jakelongo/l2_dev_board/BOM.xls

Item No. | Quantity | Description | Footprint | Reference | Manufacturer | Part Number | Unit Price (£) | Line Price (£) | Comments | Link
1 | 1 | MLCC 10nF 0603 X7R 50V | 0603 | C108 | Murata | GRM188R71H103KA01 | 0.0250 | 0.0200 |  | http://search.digikey.com/scripts/DkSearch/dksus.dll?Detail&name=490-1512-1-ND
2 | 1 | MLCC 0.22uF 0603 X7R 10V | 0603 | C103 | Murata | GRM188R71A224KA01D | 0.0930 | 0.0742 |  | http://search.digikey.com/scripts/DkSearch/dksus.dll?Detail&name=490-1535-2-ND
3 | 64 | MLCC 100nF 0402 X7R 16V | 0402 | C302,C303,C304,C305,C307,C308,C309,C310,C402,C403,C404,C405,C407,C408,C409,C410,C602,C603,C604,C605,C607,C608,C609,C610,C702,C703,C704,C705,C707,C708,C709,C710,C902,C903,C904,C905,C907,C908,C909,C910,C1002,C1003,C1004,C1005,C1007,C1008,C1009,C1010,C1202,C1203,C1204,C1205,C1207,C1208,C1209,C1210,C1302,C1303,C1304,C1305,C1307,C1308,C1309,C1310 | Murata | GRM155R71C104KA88 | 0.0182 | 0.0072 |  | http://search.digikey.com/scripts/DkSearch/dksus.dll?Detail&name=490-3261-1-ND
4 | 28 | MLCC 10uF 0805 X5R 10V | 0805 | C104,C105,C107,C109,C201,C203,C306,C311,C406,C411,C501,C503,C606,C611,C706,C711,C801,C803,C906,C911,C1006,C1011,C1101,C1103,C1206,C1211,C1306,C1311 | Murata | GRM21BR61A106KE19 | 0.2840 | 0.0945 |  | http://search.digikey.com/scripts/DkSearch/dksus.dll?Detail&name=490-1709-1-ND
5 | 8 | MLCC 100nF 0603 X7R 16V | 0603 | C301,C401,C601,C701,C901,C1001,C1201,C1301 | Murata | GRM188R71C104KA01 | 0.0260 | 0.0208 |  | http://search.digikey.com/scripts/DkSearch/dksus.dll?Detail&name=490-1532-1-ND
6 | 5 | MLCC 33pF 0603 COG 50V | 0603 | C106,C202,C502,C802,C1102 | Murata | GRM1885C1H330JA01 | 0.0390 | 0.0310 |  | http://search.digikey.com/scripts/DkSearch/dksus.dll?Detail&name=490-1415-1-ND
7 | 1 | MLCC 4.7uF 0805 X5R 25V | 0805 | C101 | Murata | GRM21BR61E475KA12L | 0.3900 | 0.3090 |  | http://search.digikey.com/scripts/DkSearch/dksus.dll?Detail&name=490-3335-1-ND
8 | 1 | MLCC 470pF 0603 X7R 50V | 0603 | C102 | Murata | GRM188R71H471KA01D | 0.0580 | 0.0466 |  | http://search.digikey.com/scripts/DkSearch/dksus.dll?Detail&name=490-1489-1-ND
9 | 8 | RES 2.2R 0603 1% 0.1W | 0603 | R301,R401,R601,R701,R901,R1001,R1201,R1301 | ROHM | MCR03EZPJ2R2 | 0.0180 | 0.0138 |  | http://search.digikey.com/scripts/DkSearch/dksus.dll?Detail&name=RHM2.2GCT-ND
10 | 27 | RES 33R 0603 1% 0.1W | 0603 | R115,R116,R117,R121,R122,R123,R124,R125,R126,R127,R128,R129,R131,R136,R141,R146,R151,R160,R165,R166,R171,R176,R181,R201,R501,R801,R1101 | ROHM | MCR03EZPFX33R0 | 0.0230 | 0.0098 |  | http://search.digikey.com/scripts/DkSearch/dksus.dll?Detail&name=RHM33.0HCT-ND
11 | 32 | RES 1k 0603 1% 0.1W | 0603 | R302,R303,R304,R305,R402,R403,R404,R405,R602,R603,R604,R605,R702,R703,R704,R705,R902,R903,R904,R905,R1002,R1003,R1004,R1005,R1202,R1203,R1204,R1205,R1302,R1303,R1304,R1305 | ROHM | MCR03EZPFX1001 | 0.0230 | 0.0098 |  | http://search.digikey.com/scripts/DkSearch/dksus.dll?Detail&name=RHM1.00KHCT-ND
12 | 8 | RES 10k 0603 1% 0.1W | 0603 | R103,R104,R105,R106,R107,R112,R113,R114 | ROHM | MCR03EZPFX1002 | 0.0230 | 0.0098 |  | http://search.digikey.com/scripts/DkSearch/dksus.dll?Detail&name=RHM10.0KHCT-ND
13 | 1 | RES 11.5k 0603 1% 0.1W | 0603 | R102 | ROHM | MCR03EZPFX1152 | 0.0230 | 0.0230 |  | http://search.digikey.com/scripts/DkSearch/dksus.dll?Detail&name=RHM11.5KHCT-ND
14 | 1 | RES 16.5k 0603 1% 0.1W | 0603 | R101 | ROHM | MCR03EZPFX1622 | 0.0230 | 0.0230 |  | http://search.digikey.com/scripts/DkSearch/dksus.dll?Detail&name=RHM16.2KHCT-ND
15 | 1 | RES 453k 0603 1% 0.1W | 0603 | R110 | ROHM | MCR03EZPFX4533 | 0.0230 | 0.0230 |  | http://search.digikey.com/scripts/DkSearch/dksus.dll?Detail&name=RHM453KHCT-ND
16 | 1 | RES 536k 0603 1% 0.1W | 0603 | R109 | ROHM | MCR03EZPFX5363 | 0.0230 | 0.0230 |  | http://search.digikey.com/scripts/DkSearch/dksus.dll?Detail&name=RHM536KHCT-ND
17 | 6 | RES 100k 0603 1% 0.1W | 0603 | R108,R111,R204,R504,R804,R1104 | ROHM | MCR03EZPJ104 | 0.0180 | 0.0138 |  | http://search.digikey.com/scripts/DkSearch/dksus.dll?Detail&name=RHM100KGCT-ND
18 | 4 | RES 68k 0603 1% 0.1W | 0603 | R203,R503,R803,R1103 | ROHM | MCR03EZPJ683 | 0.0180 | 0.0180 |  | http://search.digikey.com/scripts/DkSearch/dksus.dll?Detail&name=RHM68KGCT-ND
19 | 5 | 2u2H | NCLV | L102,L201,L501,L801,L1101 | TDK Corporation | NLCV32T-2R2M-PFR | 0.2300 | 0.2062 |  | http://search.digikey.com/scripts/DkSearch/dksus.dll?Detail&name=445-3650-1-ND
20 | 1 | 2u2H | LQH55P | L101 | Murata | LQH55PN2R2NR0L | 0.8200 | 0.6900 |  | http://search.digikey.com/scripts/DkSearch/dksus.dll?Detail&name=490-5266-1-ND
21 | 1 | 74AHC1GU04 | SOT25-5 | U111 | Diodes Inc | 74AHC1GU04W5-7 | 0.5600 | 0.3830 |  | http://search.digikey.com/scripts/DkSearch/dksus.dll?Detail&name=74AHC1GU04W5-7DICT-ND
22 | 1 | A6RS-161RF | AR6S-SWT | U103 | Omron Electronics | A6RS-161RF-P | 3.8100 | 3.8100 |  | http://search.digikey.com/scripts/DkSearch/dksus.dll?Detail&name=SW1026CT-ND
23 | 2 | APX803-SR | SOT23-3 | U101,U110 | Diodes Inc | APX803-29SRG-7 | 0.5200 | 0.4100 |  | http://search.digikey.com/scripts/DkSearch/dksus.dll?Detail&name=APX803-29SRG-7DICT-ND
24 | 1 | ASE_CLK 20Mhz | SMD-4 | U123 | Abracon Corporation | ASE-20.000MHZ-ET | 2.4000 | 2.0800 |  | http://search.digikey.com/scripts/DkSearch/dksus.dll?Detail&name=535-9983-1-ND
25 | 10 | CONN_30 | comments | P101,P102,P103,P104,P105,P106,P107,P108,P109,P110 | Toby | FFC5-30-R-L-TU | 0.6200 | 0.5200 | Check datasheet for footprint | http://www.toby.co.uk/content/catalogue/products.aspx?series=FFC5-xx-R-L-Tx
26 | 1 | CONN_7 7 PIN JTAG HEADER | N/A | P112 | N/A | N/A |  |  | DNP
27 | 1 | DIODE_SCH | DFLS240L | D101 | Diodes Inc | DFLS240L-7 | 0.7900 | 0.6840 |  | http://search.digikey.com/scripts/DkSearch/dksus.dll?Detail&name=DFLS240LDICT-ND
28 | 32 | LED GRN | 603 | D301,D302,D303,D304,D401,D402,D403,D404,D601,D602,D603,D604,D701,D702,D703,D704,D901,D902,D903,D904,D1001,D1002,D1003,D1004,D1201,D1202,D1203,D1204,D1301,D1302,D1303,D1304 | Knightsbright Corp | APT1608CGCK | 0.1020 | 0.0850 |  | http://search.digikey.com/scripts/DkSearch/dksus.dll?Detail&name=754-1116-1-ND
29 | 1 | LT3480 DC-DC BUCK 2A | 10DFN | U109 | Linear Technology | LT3480EDD#PBF | 6.9000 | 6.9000 |  | http://search.digikey.com/scripts/DkSearch/dksus.dll?Detail&name=LT3480EDD%23PBF-ND
30 | 2 | NC7WZ07 OPN DRN BUF | SC70-6 | U119,U127 | Fairchild Semiconductor | NC7WZ07P6X | 0.4700 | 0.4700 |  | http://search.digikey.com/scripts/DkSearch/dksus.dll?Detail&name=NC7WZ07P6XCT-ND
31 | 18 | NC7WZ17 BUF | SC70-6 | U112,U113,U114,U115,U118,U120,U125,U126,U128,U131,U201,U202,U501,U502,U801,U802,U1101,U1102 | Fairchild Semiconductor | NC7WZ17P6X | 0.4700 | 0.2016 |  | http://search.digikey.com/scripts/DkSearch/dksus.dll?Detail&name=NC7WZ17P6XCT-ND
32 | 5 | NCP1529 DC-DC BUCK 1A | SOT23-5 | U117,U203,U503,U803,U1103 | ON Semiconductor | NCP1529ASNT1G | 0.9500 | 0.8500 |  | http://search.digikey.com/scripts/DkSearch/dksus.dll?Detail&name=NCP1529ASNT1GOSCT-ND
33 | 1 | CON PWR JCK 2.5 X 6.5MM VERT | PJ-044BH | P111 | CUI Inc | PJ-044BH | 1.2200 | 0.8540 |  | http://search.digikey.com/scripts/DkSearch/dksus.dll?Detail&name=CP-044BH-ND
34 | 2 | SN74CBTD3861 10-BIT FET BUS SWTCH | TSSOP-24 | U108,U116 | Texas Instruments | SN74CBTD3861PWR | 0.7000 | 0.5440 |  | http://search.digikey.com/scripts/DkSearch/dksus.dll?Detail&name=296-6487-1-ND
35 | 4 | SN74LVC1G18 NON-INV DEMUX | SOT23-6 | U104,U105,U106,U107 | Texas Instruments | SN74LVC1G18DBVR | 0.4400 | 0.2852 |  | http://search.digikey.com/scripts/DkSearch/dksus.dll?Detail&name=296-15568-1-ND
36 | 8 | XS1_L2-QFN124 | QFN124 | U301,U401,U601,U701,U901,U1001,U1201,U1301 | XMOS | XS1-L02A-QF124-C5 | 9.1500 | 6.1000 |  | http://www.xmos.com/published/xs1-l02a-qf124-datasheet
37 | 12 | YC124 | 4x0402 | U102,U121,U122,U124,U129,U130,U132,U133,U134,U135,U136,U137 | YAGEO | YC124-JR-0733RL | 0.1060 | 0.0960 |  | http://uk.farnell.com/yageo-phycomp/yc124-jr-0733rl/resistor-array-arv341-0804-33r/dp/9235272
