jakelongo/l2_dev_board/XMP16/BOM/BOM.xlsx

Item No. | Reference | Quantity | Desctiption | Package | Unit Cost (£) | Line Cost (10) (£) | Datasheet
1 | C108 | 1 | CAP 0.1uF | 0603 | 0.013 | 0.003
2 | C103 | 1 | CAP 0.22uF | 0603 | 0.013 | 0.003
3 | R108, R111, R204, R504, R804, R1104 | 6 | RES 100k | 0603 | 0.110 | 0.002
4 | C302, C303, C304, C305, C307, C308, C309, C310, C402, C403, C404, C405, C407, C408, C409, C410, C602, C603, C604, C605, C607, C608, C609, C610, C702, C703, C704, C705, C707, C708, C709, C710, C902, C903, C904, C905, C907, C908, C909, C910, C1002, C1003, C1004, C1005, C1007, C1008, C1009, C1010, C1202, C1203, C1204, C1205, C1207, C1208, C1209, C1210, C1302, C1303, C1304, C1305, C1307, C1308, C1309, C1310 | 64 | RES 100nF | 0402 | 0.013 | 0.003
5 | R103, R104, R105, R106, R107, R112, R113, R114 | 8 | RES 10k | 0603 | 0.110 | 0.002
6 | C105, C107, C201, C203, C306, C311, C406, C411, C501, C503, C606, C611, C706, C711, C801, C803, C906, C911, C1006, C1011, C1101, C1103, C1206, C1211, C1306, C1311 | 26 | CAP 10uF | 0603 | 0.013 | 0.003
7 | R102 | 1 | RES 11.5k | 0603 | 0.110 | 0.002
8 | C104 | 1 | CAP 15uF | 0603 | 0.013 | 0.003
9 | R101 | 1 | RES 16.2k | 0603 | 0.110 | 0.002
10 | R302, R303, R304, R305, R402, R403, R404, R405, R602, R603, R604, R605, R702, R703, R704, R705, R902, R903, R904, R905, R1002, R1003, R1004, R1005, R1202, R1203, R1204, R1205, R1302, R1303, R1304, R1305 | 32 | RES 1k | 0603 | 0.110 | 0.002
11 | C301, C401, C601, C701, C901, C1001, C1201, C1301 | 8 | CAP 1uF | 0603 | 0.013 | 0.003
12 | R301, R401, R601, R701, R901, R1001, R1201, R1301 | 8 | RES 2R2 | 0603 | 0.110 | 0.002
13 | L102, L201, L501, L801, L1101 | 5 | IND 2u2H | NCLV | 0.160 | 0.140 | http://search.digikey.com/scripts/DkSearch/dksus.dll?Detail&name=445-3650-1-ND
14 | L101 | 1 | IND 2u2H | LQH55P | 0.560 | 0.469 | http://search.murata.co.jp/Ceramy/image/img/PDF/ENG/L0075S0103LQH55P.pdf
15 | C106, C202, C502, C802, C1102 | 5 | CAP 33pF | 0603 | 0.013 | 0.003
16 | R115, R116, R117, R121, R122, R123, R124, R125, R126, R127, R128, R129, R131, R136, R141, R146, R151, R160, R165, R166, R171, R176, R181, R201, R501, R801, R1101 | 27 | RES 33R | 0603 | 0.110 | 0.002
17 | C101 | 1 | CAP 4.7uF | 0603 | 0.013 | 0.003
18 | R110 | 1 | RES 453k | 0603 | 0.110 | 0.002
19 | C102 | 1 | CAP 470pF | 0603 | 0.013 | 0.003
20 | R109 | 1 | RES 536k | 0603 | 0.110 | 0.002
21 | R203, R503, R803, R1103 | 4 | RES 68k | 0603 | 0.110 | 0.002
22 | U111 | 1 | 74AHC1GU04 | SOT25-5 | 0.380 | 0.260 | http://search.digikey.com/scripts/DkSearch/dksus.dll?Detail&name=74AHC1GU04W5-7DICT-ND
23 | U103 | 1 | A6RS-161RF | AR6S-SWT | 2.590 | 2.590 | http://search.digikey.com/scripts/DkSearch/dksus.dll?Detail&name=SW1026CT-ND
24 | U101, U110 | 2 | APX803-SR | SOT23-3 | 0.450 | 0.346 | http://search.digikey.com/scripts/DkSearch/dksus.dll?Detail&name=535-9983-1-ND
25 | U123 | 1 | ASE_CLK | SMD-4 | 1.630 | 1.413 | http://search.digikey.com/scripts/DkSearch/dksus.dll?Detail&name=535-9983-1-ND
26 | P101, P102, P103, P104, P105, P106, P107, P108, P109, P110 | 10 | CONN_30 |  | 0.620 | 0.520 | http://www.toby.co.uk/content/catalogue/products.aspx?series=FFC5-xx-R-L-Tx
27 | D101 | 1 | DIODE_SCH | DFLS240L | 0.540 | 0.465 | http://search.digikey.com/scripts/DkSearch/dksus.dll?Detail&name=DFLS240LDICT-ND
28 | D301, D302, D303, D304, D401, D402, D403, D404, D601, D602, D603, D604, D701, D702, D703, D704, D901, D902, D903, D904, D1001, D1002, D1003, D1004, D1201, D1202, D1203, D1204, D1301, D1302, D1303, D1304 | 32 | LED | 603 | 0.520 | 0.099 | http://search.digikey.com/scripts/DkSearch/dksus.dll?Detail&name=296-23770-1-ND
29 | U109 | 1 | LT3480 | 10DFN | 4.970 | 4.970 | http://search.digikey.com/scripts/DkSearch/dksus.dll?Detail&name=LT3480EDD%23PBF-ND
30 | U119, U127 | 2 | NC7WZ07 | SC70-6 | 0.320 | 0.137 | http://search.digikey.com/scripts/DkSearch/dksus.dll?Detail&name=NC7WZ17P6XCT-ND
31 | U112, U113, U114, U115, U118, U120, U125, U126, U128, U131, U201, U202, U501, U502, U801, U802, U1101, U1102 | 18 | NC7WZ17 | SC70-6 | 0.320 | 0.137 | http://search.digikey.com/scripts/DkSearch/dksus.dll?Detail&name=NC7WZ17P6XCT-ND
32 | U117, U203, U503, U803, U1103 | 5 | NCP1529 | SOT23-5 | 0.650 | 0.577 | http://search.digikey.com/scripts/DkSearch/dksus.dll?Detail&name=NCP1529ASNT1GOSCT-ND
33 | U108, U116 | 2 | SN74CBTD3861 | TSSOP-24 | 0.480 | 0.480 | http://search.digikey.com/scripts/DkSearch/dksus.dll?Detail&name=296-6487-1-ND
34 | U104, U105, U106, U107 | 4 | SN74LVC1G18 | SOT23-6 | 0.300 | 0.194 | http://search.digikey.com/scripts/DkSearch/dksus.dll?Detail&name=296-15568-1-ND
35 | U301, U401, U601, U701, U901, U1001, U1201, U1301 | 8 | XS1_L2-QFN124 |  | 9.158 | 6.105 | http://www.xmos.com/published/xs1-l02a-qf124-datasheet
36 | U102, U121, U122, U124, U129, U130, U132, U133, U134, U135, U136, U137 | 12 | YC124 | 4x0402 | 0.106 | 0.103 | http://uk.farnell.com/yageo-phycomp/yc124-jr-0733rl/resistor-array-arv341-0804-33r/dp/9235272
37 | P111 | 1 | POWER JACK PJ-044BH | PJ-044BH | 0.830 | 0.580 | http://search.digikey.com/scripts/DkSearch/dksus.dll?Detail&name=CP-044BH-ND
