jakelongo/l2_dev_board/l2_dev_alternative _nopwrsense/l1.sch

## KiCad design l2_dev_alternative _nopwrsense/l1.sch (2011-08-31)

Schematic: l1.sch

Parts:
C1401, C1402, C1405, C1406, C1412, C1417: 10uF
C1403, C1404: 33pF
C1407, C1408, C1409, C1410, C1413, C1414, C1415, C1416: 100nF
C1411: 1uF
L1401, L1402: 2u2H
R1403: 453k
R1404, R1406: 100k
R1405: 68k
R1407, R1409: 10k
R1408: 4R7
U1401, U1402: NC7WZ17
U1403: NCP1529
U1404: NCP1521B
U1405, U1406: APX803-SR
U1407: XS1-L1-128

Notes on the sheet:
L1 128 TQFP
RESET SUPERVISOR
Decoupling Caps
5V to 1V0 @ 0.6A
5V to 3V3 @ 1A
JTAG Buffering
