jakelongo/l2_dev_board/l2_dev_alternative _nopwrsense/l2.sch

## KiCad design l2_dev_alternative _nopwrsense/l2.sch (2011-09-13)

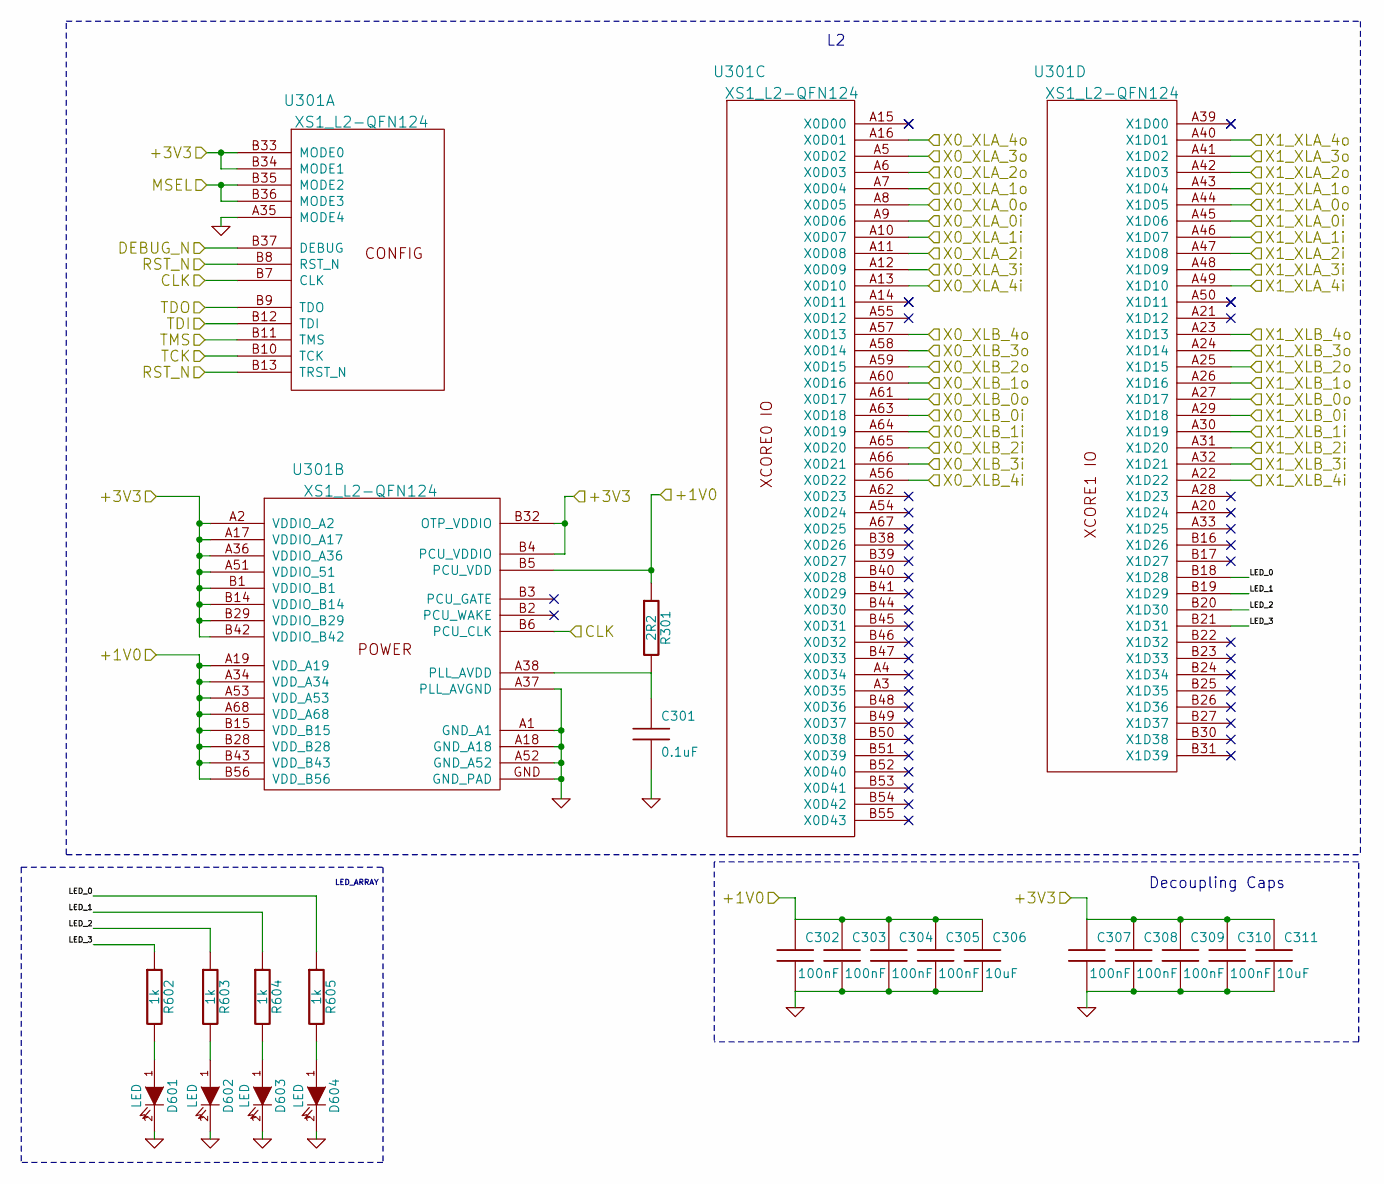
[picture p1: schematic l2.sch]

Parts:
C301: 0.1uF; 0603
C302, C303, C304, C305, C307, C308, C309, C310: 100nF; 0402
C306, C311: 10uF; 0603
D302, D303, D304, D401: LED; 0603
R301: 2R2; 0603
R303, R304, R305, R402: 1k; 0603
U301: XS1_L2-QFN124; QFN124

Connections:
+1V0: C302.1, C303.1, C304.1, C305.1, C306.1, R301.1, U301.A19 (VDD_A19), U301.A34 (VDD_A34), U301.A53 (VDD_A53), U301.A68 (VDD_A68), U301.B5 (PCU_VDD), U301.B15 (VDD_B15), U301.B28 (VDD_B28), U301.B43 (VDD_B43), U301.B56 (VDD_B56)
+3V3: C307.1, C308.1, C309.1, C310.1, C311.1, U301.A2 (VDDIO_A2), U301.A17 (VDDIO_A17), U301.A36 (VDDIO_A36), U301.A51 (VDDIO_51), U301.B1 (VDDIO_B1), U301.B4 (PCU_VDDIO), U301.B14 (VDDIO_B14), U301.B29 (VDDIO_B29), U301.B32 (OTP_VDDIO), U301.B33 (MODE0), U301.B34 (MODE1), U301.B42 (VDDIO_B42)
CLK: U301.B6 (PCU_CLK), U301.B7 (CLK)
DEBUG_N: U301.B37 (DEBUG)
GND: C301.2, C302.2, C303.2, C304.2, C305.2, C306.2, C307.2, C308.2, C309.2, C310.2, C311.2, D302.2 (K), D303.2 (K), D304.2 (K), D401.2 (K), U301.A1 (GND_A1), U301.A18 (GND_A18), U301.A35 (MODE4), U301.A37 (PLL_AVGND), U301.A52 (GND_A52), U301.GND (GND_PAD)
LED_0: R305.1, U301.B18 (X1D28)
LED_1: R304.1, U301.B19 (X1D29)
LED_2: R303.1, U301.B20 (X1D30)
LED_3: R402.1, U301.B21 (X1D31)
MSEL: U301.B35 (MODE2), U301.B36 (MODE3)
unnamed: C301.1, R301.2, U301.A38 (PLL_AVDD)
unnamed: D302.1 (A), R303.2
unnamed: D303.1 (A), R304.2
unnamed: D304.1 (A), R305.2
unnamed: D401.1 (A), R402.2
RST_N: U301.B8 (RST_N), U301.B13 (TRST_N)
TCK: U301.B10 (TCK)
TDI: U301.B12 (TDI)
TDO: U301.B9 (TDO)
TMS: U301.B11 (TMS)
X0_XLA_0i: U301.A9 (X0D06)
X0_XLA_0o: U301.A8 (X0D05)
X0_XLA_1i: U301.A10 (X0D07)
X0_XLA_1o: U301.A7 (X0D04)
X0_XLA_2i: U301.A11 (X0D08)
X0_XLA_2o: U301.A6 (X0D03)
X0_XLA_3i: U301.A12 (X0D09)
X0_XLA_3o: U301.A5 (X0D02)
X0_XLA_4i: U301.A13 (X0D10)
X0_XLA_4o: U301.A16 (X0D01)
X0_XLB_0i: U301.A63 (X0D18)
X0_XLB_0o: U301.A61 (X0D17)
X0_XLB_1i: U301.A64 (X0D19)
X0_XLB_1o: U301.A60 (X0D16)
X0_XLB_2i: U301.A65 (X0D20)
X0_XLB_2o: U301.A59 (X0D15)
X0_XLB_3i: U301.A66 (X0D21)
X0_XLB_3o: U301.A58 (X0D14)
X0_XLB_4i: U301.A56 (X0D22)
X0_XLB_4o: U301.A57 (X0D13)
X1_XLA_0i: U301.A45 (X1D06)
X1_XLA_0o: U301.A44 (X1D05)
X1_XLA_1i: U301.A46 (X1D07)
X1_XLA_1o: U301.A43 (X1D04)
X1_XLA_2i: U301.A47 (X1D08)
X1_XLA_2o: U301.A42 (X1D03)
X1_XLA_3i: U301.A48 (X1D09)
X1_XLA_3o: U301.A41 (X1D02)
X1_XLA_4i: U301.A49 (X1D10)
X1_XLA_4o: U301.A40 (X1D01)
X1_XLB_0i: U301.A29 (X1D18)
X1_XLB_0o: U301.A27 (X1D17)
X1_XLB_1i: U301.A30 (X1D19)
X1_XLB_1o: U301.A26 (X1D16)
X1_XLB_2i: U301.A31 (X1D20)
X1_XLB_2o: U301.A25 (X1D15)
X1_XLB_3i: U301.A32 (X1D21)
X1_XLB_3o: U301.A24 (X1D14)
X1_XLB_4i: U301.A22 (X1D22)
X1_XLB_4o: U301.A23 (X1D13)

Notes on the sheet:
LED_ARRAY
Decoupling Caps
