jakelongo/l2_dev_board/l2_dev_alternative _nopwrsense/l2_dev_board.sch

## KiCad design l2_dev_alternative _nopwrsense/l2_dev_board.sch (2011-09-13)

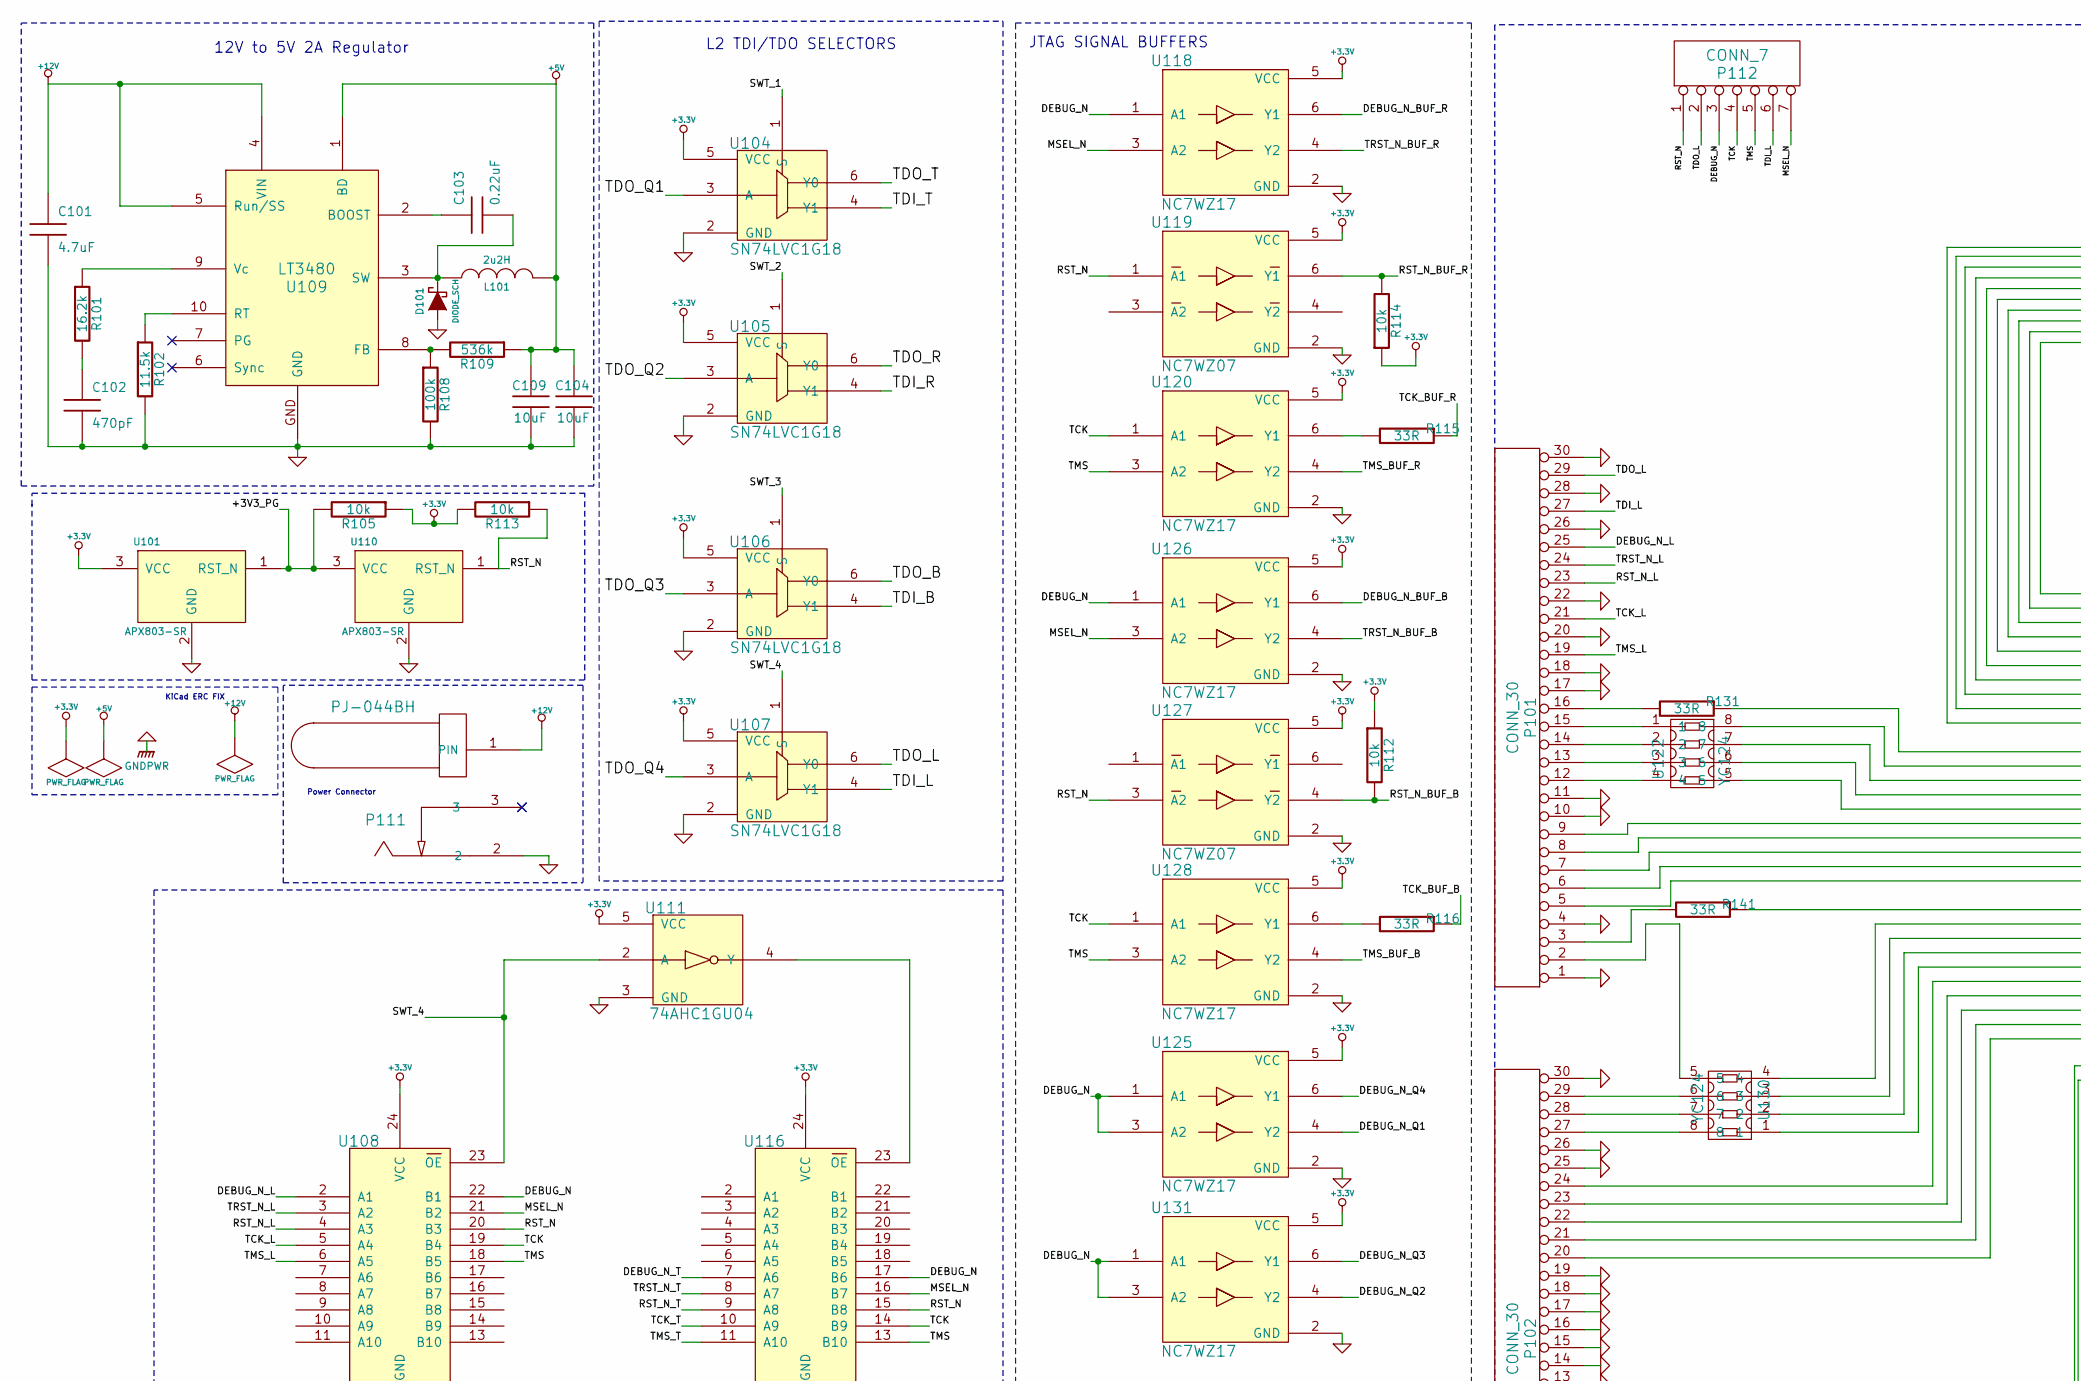
[picture p2: schematic l2_dev_board.sch, part in row 1, column 1]

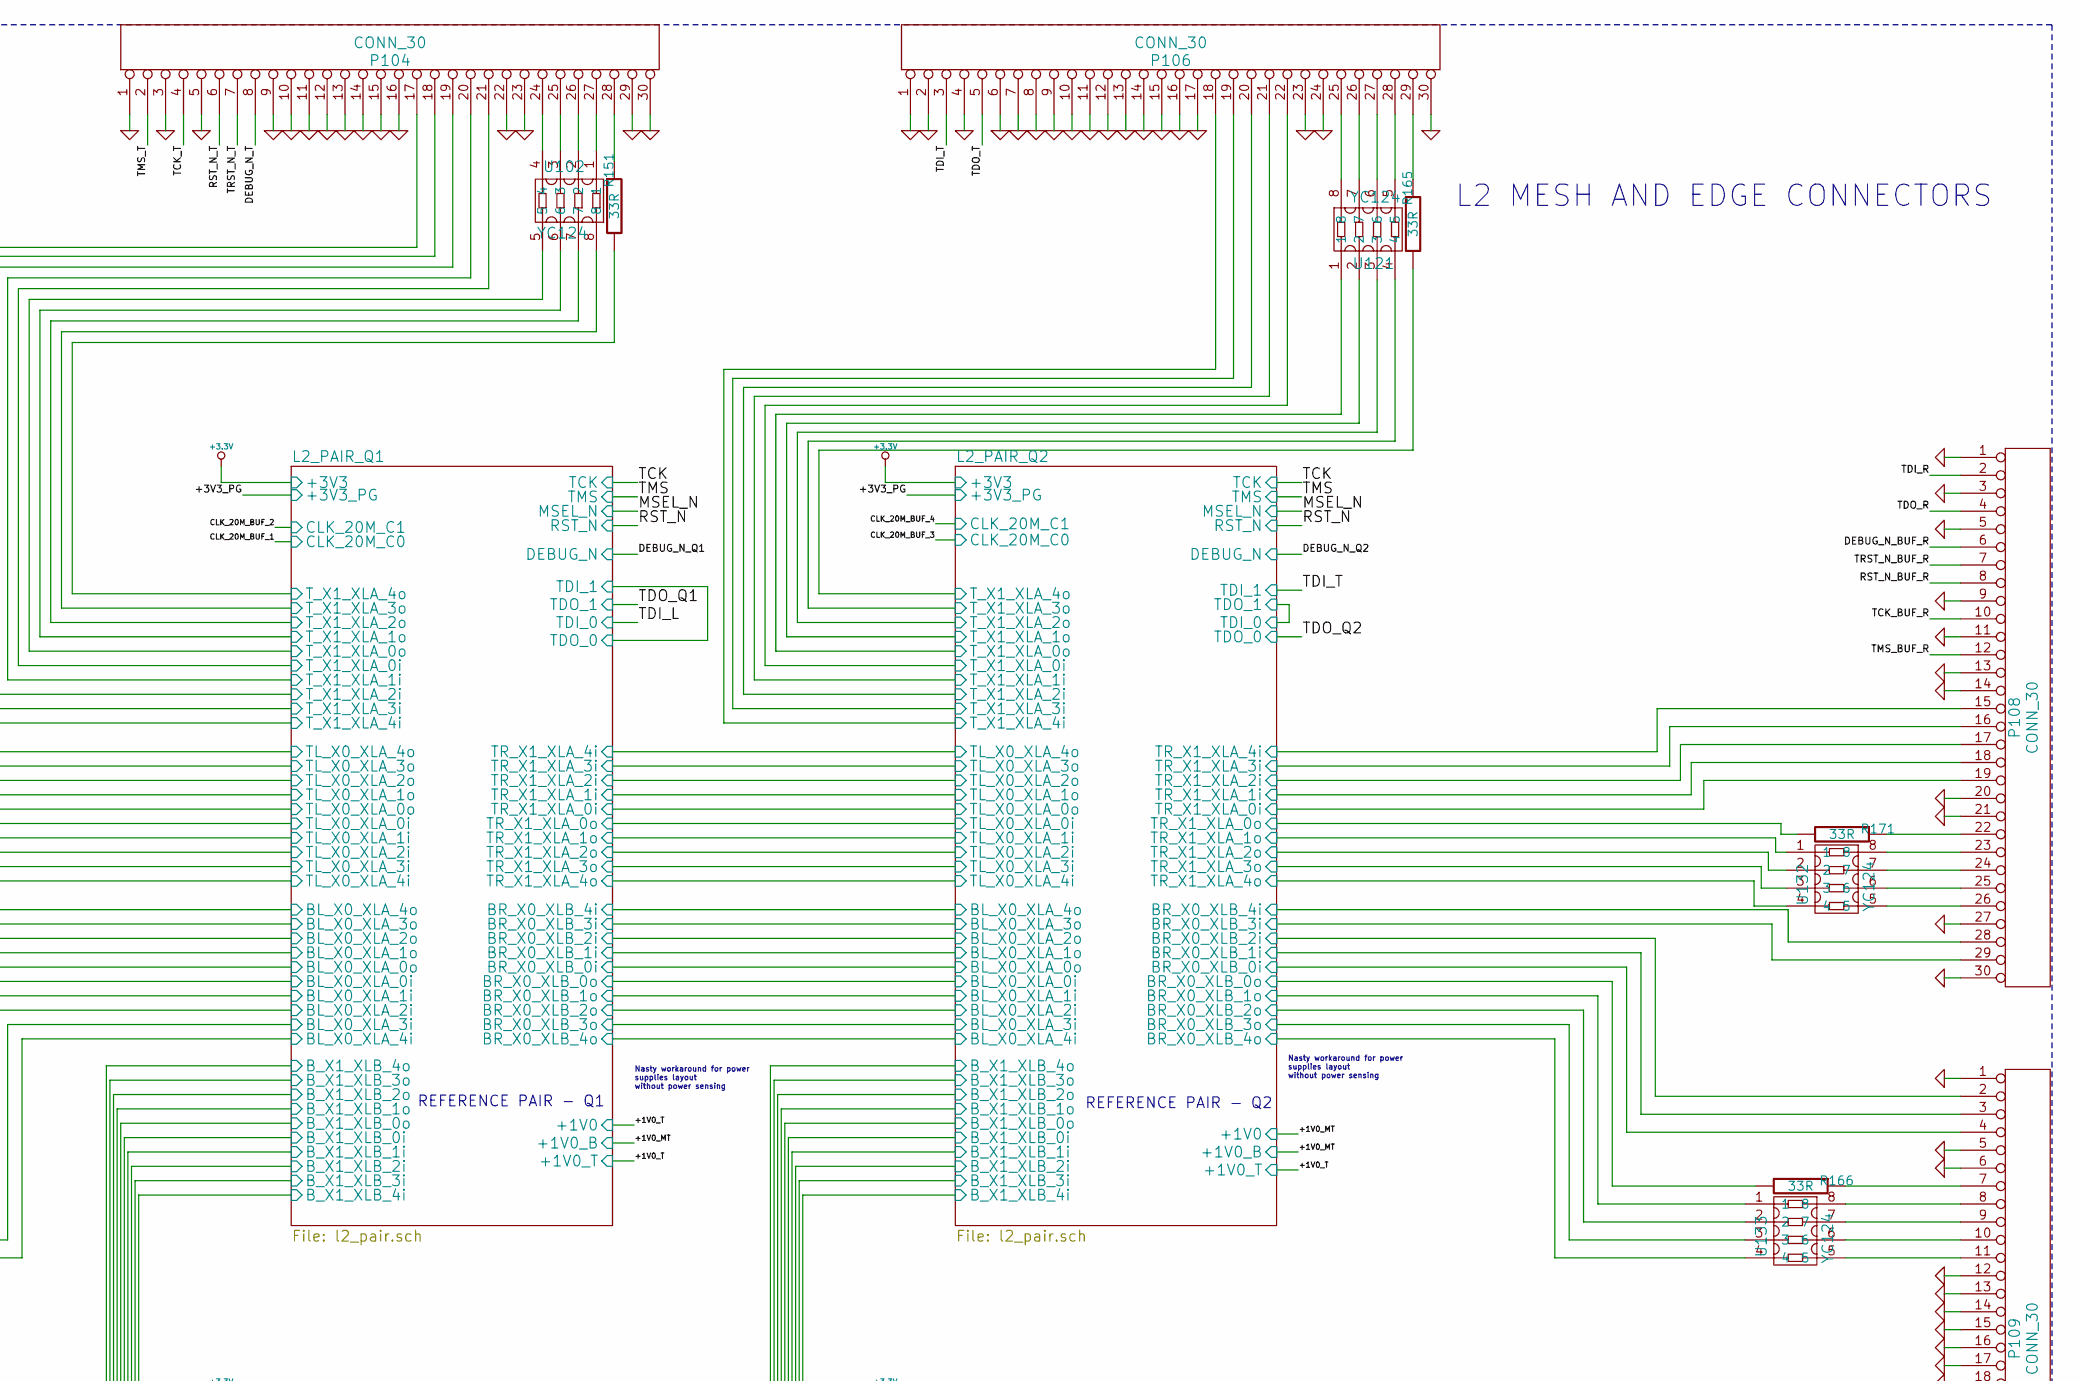
[picture p3: schematic l2_dev_board.sch, part in row 1, column 2]

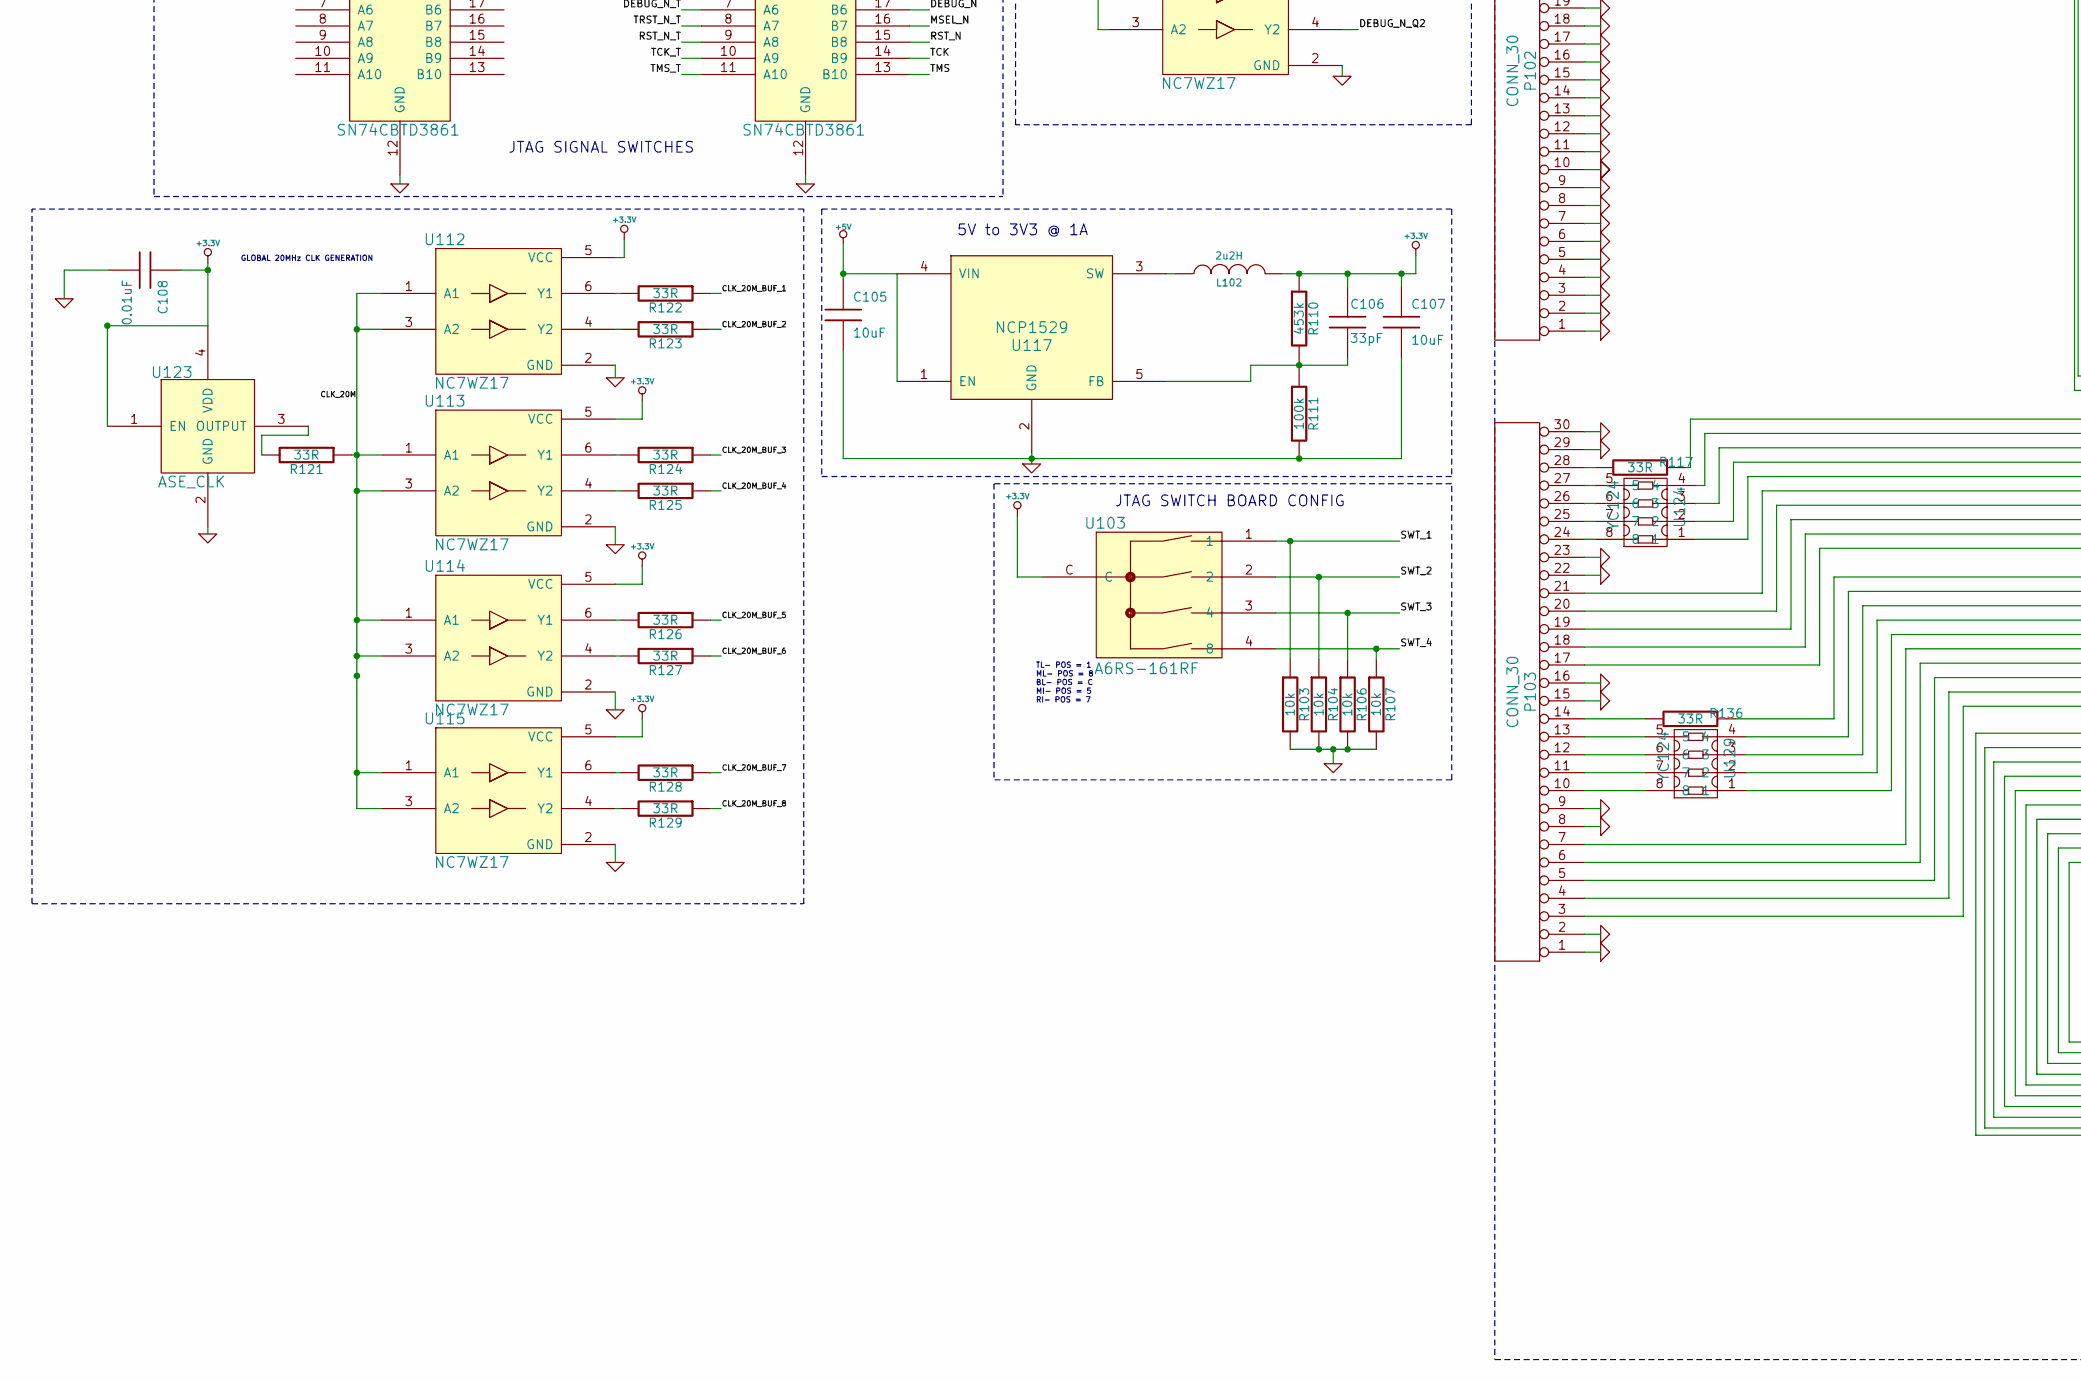
[picture p4: schematic l2_dev_board.sch, part in row 2, column 1]

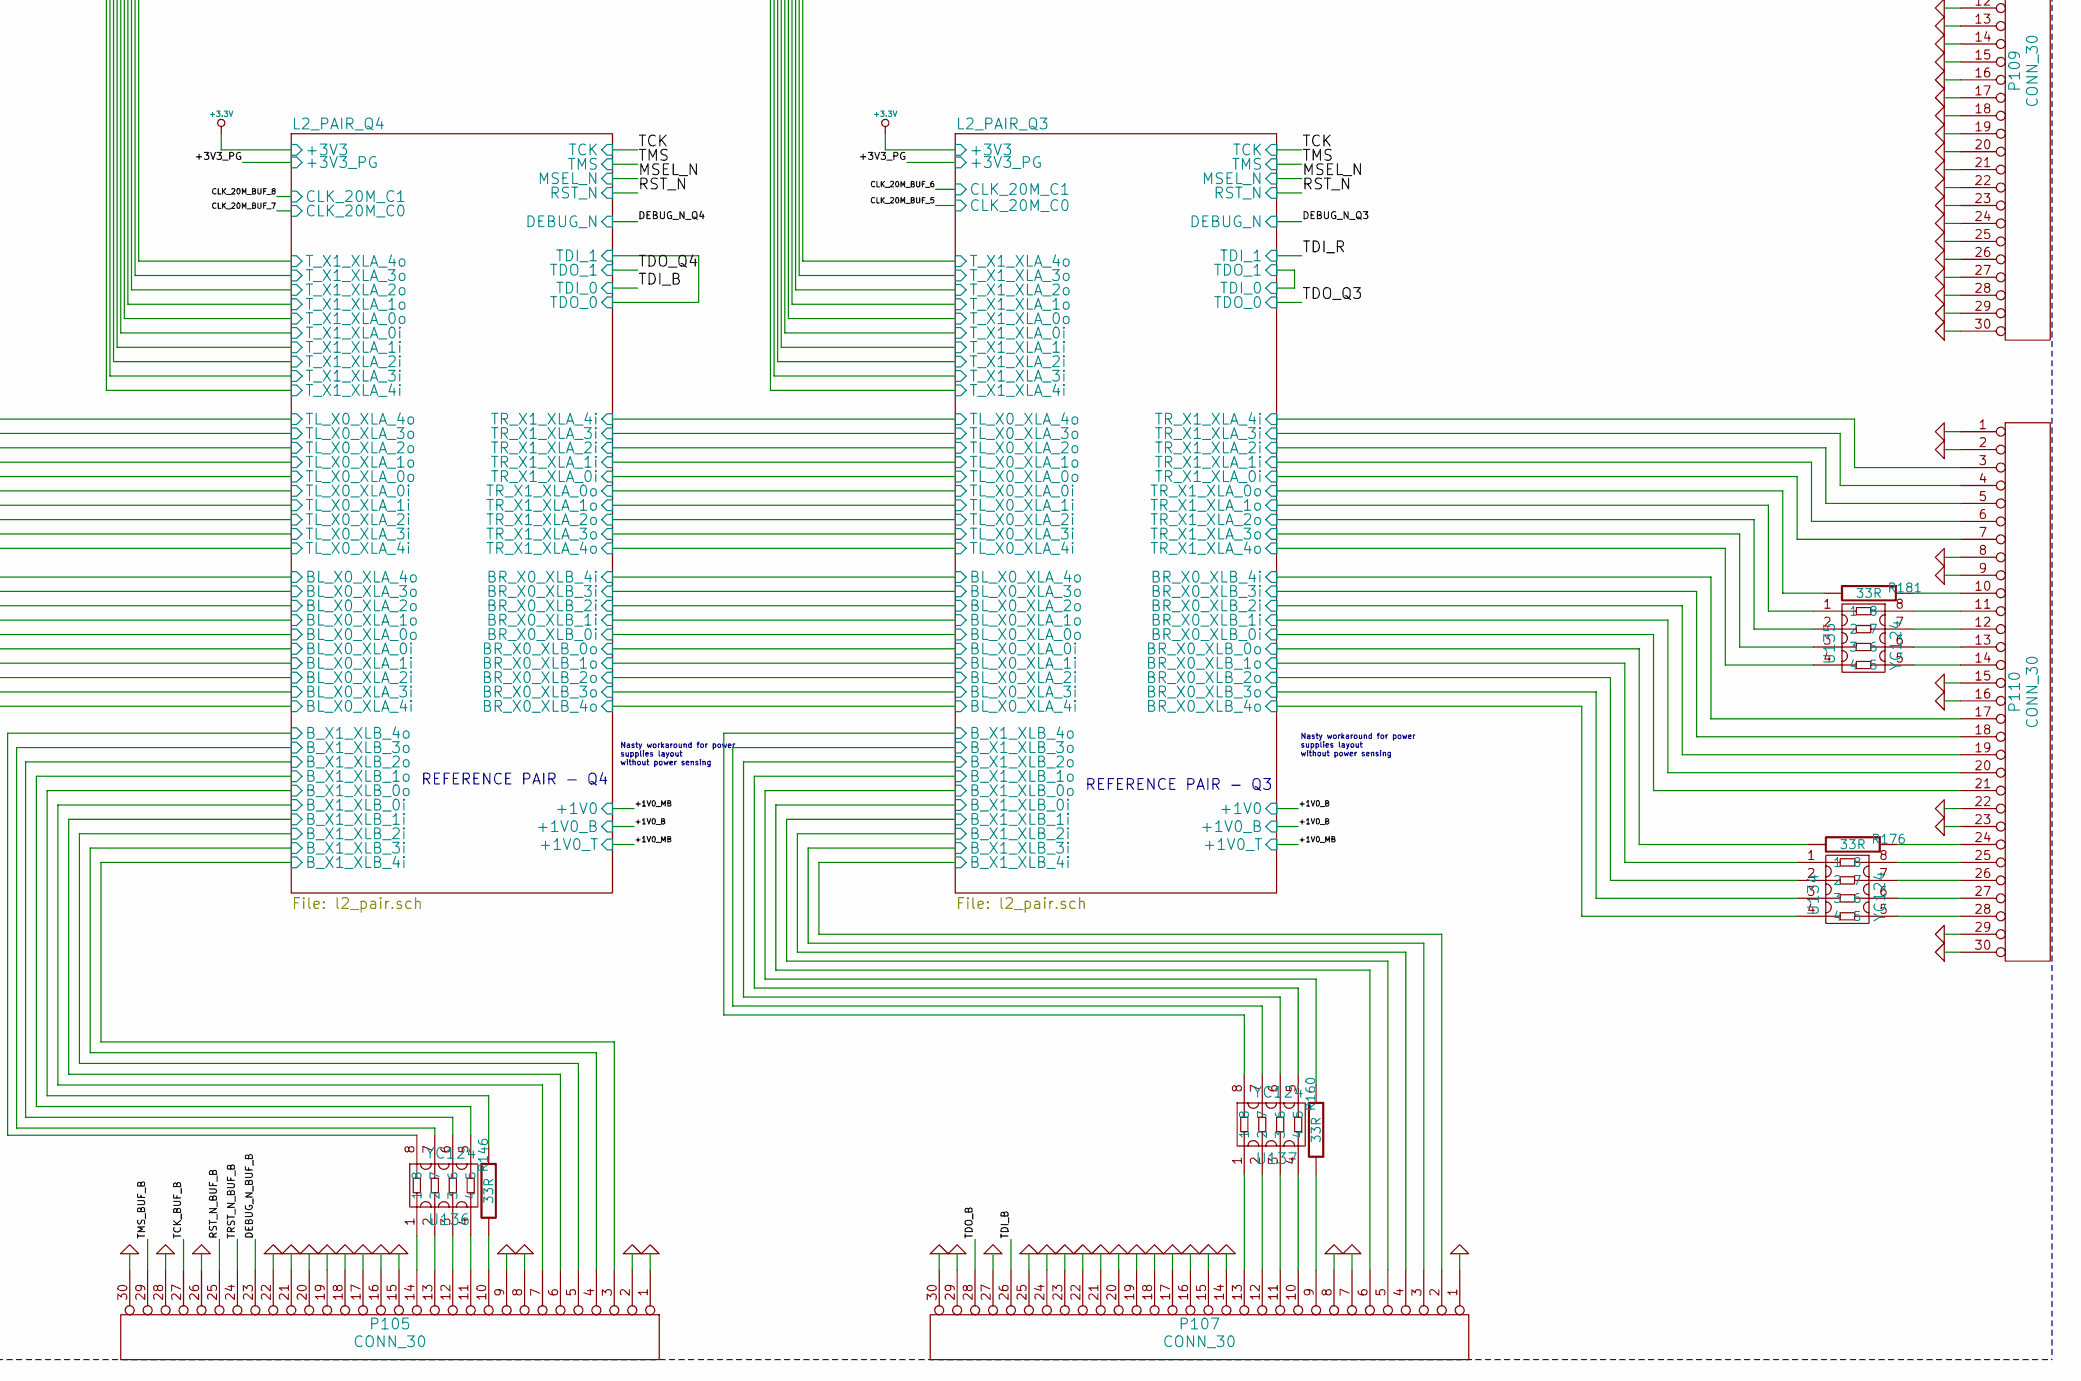
[picture p5: schematic l2_dev_board.sch, part in row 2, column 2]

Parts:
C101: 4.7uF; 0603
C102: 470pF; 0603
C103: 0.22uF; 0603
C104, C105, C107, C109: 10uF; 0603
C106: 33pF; 0603
C108: 0.01uF; 0603
D101: DIODE_SCH; DFLS240L
L101: 2u2H; LQH55P
L102: 2u2H
P101, P102, P103, P104, P105, P106, P107, P108, P109, P110: CONN_30
P111: PJ-044BH
P112: CONN_7
R101: 16.2k; 0603
R102: 11.5k; 0603
R103, R104, R105, R106, R107, R112, R113, R114: 10k; 0603
R108, R111: 100k; 0603
R109: 536k; 0603
R110: 453k; 0603
R115, R116, R117, R121, R122, R123, R124, R125, R126, R127, R128, R129, R131, R136, R141, R146, R151, R160, R165, R166, R171, R176, R181: 33R; 0603
U101, U110: APX803-SR; SOT23-3
U102, U121, U122, U124, U129, U130, U132, U133, U134, U135, U136, U137: YC124; 4x0402
U103: A6RS-161RF; AR6S-SWT
U104, U105, U106, U107: SN74LVC1G18; SOT23-6
U108, U116: SN74CBTD3861; TSSOP-24
U109: LT3480; 10DFN
U111: 74AHC1GU04; SOT25-5
U112, U113, U114, U115, U118, U120, U125, U126, U128, U131: NC7WZ17; SC70-6
U117: NCP1529; SOT23-5
U119, U127: NC7WZ07; SC70-6
U123: ASE_CLK; SMD-4

Connections:
+3.3V: C106.1, C107.1, C108.1, L102.2, R105.1, R110.1, R112.1, R113.2, R114.1, U101.3 (VCC), U103.C, U104.5 (VCC), U105.5 (VCC), U106.5 (VCC), U107.5 (VCC), U108.24 (VCC), U111.5 (VCC), U112.5 (VCC), U113.5 (VCC), U114.5 (VCC), U115.5 (VCC), U116.24 (VCC), U118.5 (VCC), U119.5 (VCC), U120.5 (VCC), U123.1 (EN), U123.4 (VDD), U125.5 (VCC), U126.5 (VCC), U127.5 (VCC), U128.5 (VCC), U131.5 (VCC)
+3V3_PG: R105.2, U101.1 (RST_N), U110.3 (VCC)
+5V: C104.1, C105.1, C109.1, L101.2, R109.1, U109.1 (BD), U117.1 (EN), U117.4 (VIN)
+12V: C101.1, P111.1 (PIN), U109.4 (VIN), U109.5 (Run/SS)
BL_X0_XLA_0i: P102.24, P103.7
BL_X0_XLA_0o: U129.1, U130.1
BL_X0_XLA_1i: P102.23, P103.6
BL_X0_XLA_1o: U129.2, U130.2
BL_X0_XLA_2i: P102.22, P103.5
BL_X0_XLA_2o: U129.3, U130.3
BL_X0_XLA_3i: P102.21, P103.4
BL_X0_XLA_3o: U129.4, U130.4
BL_X0_XLA_4i: P102.20, P103.3
BL_X0_XLA_4o: R136.1, R141.1
BR_X0_XLB_0i: P109.4, P110.21
BR_X0_XLB_0o: R166.2, R176.2
BR_X0_XLB_1i: P109.3, P110.20
BR_X0_XLB_1o: U133.1, U134.1
BR_X0_XLB_2i: P109.2, P110.19
BR_X0_XLB_2o: U133.2, U134.2
BR_X0_XLB_3i: P108.29, P110.18
BR_X0_XLB_3o: U133.3, U134.3
BR_X0_XLB_4i: P108.28, P110.17
BR_X0_XLB_4o: U133.4, U134.4
B_X1_XLB_0i: P105.7, P107.6
B_X1_XLB_0o: R146.1, R160.1
B_X1_XLB_1i: P105.6, P107.5
B_X1_XLB_1o: U136.5, U137.5
B_X1_XLB_2i: P105.5, P107.4
B_X1_XLB_2o: U136.6, U137.6
B_X1_XLB_3i: P105.4, P107.3
B_X1_XLB_3o: U136.7, U137.7
B_X1_XLB_4i: P105.3, P107.2
B_X1_XLB_4o: U136.8, U137.8
CLK_20M: R121.1, U112.1 (A1), U112.3 (A2), U113.1 (A1), U113.3 (A2), U114.1 (A1), U114.3 (A2), U115.1 (A1), U115.3 (A2)
CLK_20M_BUF_1: R122.1
CLK_20M_BUF_2: R123.1
CLK_20M_BUF_3: R124.1
CLK_20M_BUF_4: R125.1
CLK_20M_BUF_5: R126.1
CLK_20M_BUF_6: R127.1
CLK_20M_BUF_7: R128.1
CLK_20M_BUF_8: R129.1
DEBUG_N: P112.3, U108.22 (B1), U116.17 (B6), U118.1 (A1), U125.1 (A1), U125.3 (A2), U126.1 (A1), U131.1 (A1), U131.3 (A2)
DEBUG_N_BUF_B: P105.23, U126.6 (Y1)
DEBUG_N_BUF_R: P108.6, U118.6 (Y1)
DEBUG_N_L: P101.25, U108.2 (A1)
DEBUG_N_Q1: U125.4 (Y2)
DEBUG_N_Q2: U131.4 (Y2)
DEBUG_N_Q3: U131.6 (Y1)
DEBUG_N_Q4: U125.6 (Y1)
DEBUG_N_T: P104.8, U116.7 (A6)
GND: C101.2, C102.2, C104.2, C105.2, C107.2, C108.2, C109.2, D101.1 (A), P101.1, P101.4, P101.10, P101.11, P101.17, P101.18, P101.20, P101.22, P101.26, P101.28, P101.30, P102.1, P102.2, P102.3, P102.4, P102.5, P102.6, P102.7, P102.8, P102.9, P102.10, P102.11, P102.12, P102.13, P102.14, P102.15, P102.16, P102.17, P102.18, P102.19, P102.25, P102.26, P102.30, P103.1, P103.2, P103.8, P103.9, P103.15, P103.16, P103.22, P103.23, P103.29, P103.30, P104.1, P104.3, P104.5, P104.9, P104.10, P104.11, P104.12, P104.13, P104.14, P104.15, P104.16, P104.22, P104.23, P104.29, P104.30, P105.1, P105.2, P105.8, P105.9, P105.15, P105.16, P105.17, P105.18, P105.19, P105.20, P105.21, P105.22, P105.26, P105.28, P105.30, P106.1, P106.2, P106.4, P106.6, P106.7, P106.8, P106.9, P106.10, P106.11, P106.12, P106.13, P106.14, P106.15, P106.16, P106.17, P106.23, P106.24, P106.30, P107.1, P107.7, P107.8, P107.14, P107.15, P107.16, P107.17, P107.18, P107.19, P107.20, P107.21, P107.22, P107.23, P107.24, P107.25, P107.27, P107.29, P107.30, P108.1, P108.3, P108.5, P108.9, P108.11, P108.13, P108.14, P108.20, P108.21, P108.27, P108.30, P109.1, P109.5, P109.6, P109.12, P109.13, P109.14, P109.15, P109.16, P109.17, P109.18, P109.19, P109.20, P109.21, P109.22, P109.23, P109.24, P109.25, P109.26, P109.27, P109.28, P109.29, P109.30, P110.1, P110.2, P110.8, P110.9, P110.15, P110.16, P110.22, P110.23, P110.29, P110.30, P111.2, R102.2, R103.2, R104.2, R106.2, R107.2, R108.2, R111.2, U101.2 (GND), U104.2 (GND), U105.2 (GND), U106.2 (GND), U107.2 (GND), U108.12 (GND), U109.GND, U110.2 (GND), U111.3 (GND), U112.2 (GND), U113.2 (GND), U114.2 (GND), U115.2 (GND), U116.12 (GND), U117.2 (GND), U118.2 (GND), U119.2 (GND), U120.2 (GND), U123.2 (GND), U125.2 (GND), U126.2 (GND), U127.2 (GND), U128.2 (GND), U131.2 (GND)
MSEL_N: P112.7, U108.21 (B2), U116.16 (B7), U118.3 (A2), U126.3 (A2)
unnamed: C102.1, R101.2
unnamed: C103.1, U109.2 (BOOST)
unnamed: C103.2, D101.2 (K), L101.1, U109.3 (SW)
unnamed: C106.2, R110.2, R111.1, U117.5 (FB)
unnamed: L102.1, U117.3 (SW)
unnamed: P101.2, U130.5
unnamed: P101.3, R141.2
unnamed: P101.12, U122.4
unnamed: P101.13, U122.3
unnamed: P101.14, U122.2
unnamed: P101.15, U122.1
unnamed: P101.16, R131.2
unnamed: P102.27, U130.8
unnamed: P102.28, U130.7
unnamed: P102.29, U130.6
unnamed: P103.10, U129.8
unnamed: P103.11, U129.7
unnamed: P103.12, U129.6
unnamed: P103.13, U129.5
unnamed: P103.14, R136.2
unnamed: P103.24, U124.8
unnamed: P103.25, U124.7
unnamed: P103.26, U124.6
unnamed: P103.27, U124.5
unnamed: P103.28, R117.2
unnamed: P104.24, U102.4
unnamed: P104.25, U102.3
unnamed: P104.26, U102.2
unnamed: P104.27, U102.1
unnamed: P104.28, R151.1
unnamed: P105.10, R146.2
unnamed: P105.11, U136.4
unnamed: P105.12, U136.3
unnamed: P105.13, U136.2
unnamed: P105.14, U136.1
unnamed: P106.25, U121.8
unnamed: P106.26, U121.7
unnamed: P106.27, U121.6
unnamed: P106.28, U121.5
unnamed: P106.29, R165.1
unnamed: P107.9, R160.2
unnamed: P107.10, U137.4
unnamed: P107.11, U137.3
unnamed: P107.12, U137.2
unnamed: P107.13, U137.1
unnamed: P108.22, R171.1
unnamed: P108.23, U132.8
unnamed: P108.24, U132.7
unnamed: P108.25, U132.6
unnamed: P108.26, U132.5
unnamed: P109.7, R166.1
unnamed: P109.8, U133.8
unnamed: P109.9, U133.7
unnamed: P109.10, U133.6
unnamed: P109.11, U133.5
unnamed: P110.10, R181.1
unnamed: P110.11, U135.8
unnamed: P110.12, U135.7
unnamed: P110.13, U135.6
unnamed: P110.14, U135.5
unnamed: P110.24, R176.1
unnamed: P110.25, U134.8
unnamed: P110.26, U134.7
unnamed: P110.27, U134.6
unnamed: P110.28, U134.5
unnamed: R101.1, U109.9 (Vc)
unnamed: R102.1, U109.10 (RT)
unnamed: R109.2, U109.8 (FB)
unnamed: R115.2, U120.6 (Y1)
unnamed: R116.2, U128.6 (Y1)
unnamed: R121.2, U123.3 (OUTPUT)
unnamed: R122.2, U112.6 (Y1)
unnamed: R123.2, U112.4 (Y2)
unnamed: R124.2, U113.6 (Y1)
unnamed: R125.2, U113.4 (Y2)
unnamed: R126.2, U114.6 (Y1)
unnamed: R127.2, U114.4 (Y2)
unnamed: R128.2, U115.6 (Y1)
unnamed: R129.2, U115.4 (Y2)
unnamed: U111.4 (Y), U116.23 (OE)
RST_N: P112.1, R113.1, U108.20 (B3), U110.1 (RST_N), U116.15 (B8), U119.1 (A1), U127.3 (A2)
RST_N_BUF_B: P105.25, R112.2, U127.4 (Y2)
RST_N_BUF_R: P108.8, R114.2, U119.6 (Y1)
RST_N_L: P101.23, U108.4 (A3)
RST_N_T: P104.6, U116.9 (A8)
SWT_1: R103.1, U103.1, U104.1 (S)
SWT_2: R104.1, U103.2, U105.1 (S)
SWT_3: R106.1, U103.3 (4), U106.1 (S)
SWT_4: R107.1, U103.4 (8), U107.1 (S), U108.23 (OE), U111.2 (A)
TCK: P112.4, U108.19 (B4), U116.14 (B9), U120.1 (A1), U128.1 (A1)
TCK_BUF_B: P105.27, R116.1
TCK_BUF_R: P108.10, R115.1
TCK_L: P101.21, U108.5 (A4)
TCK_T: P104.4, U116.10 (A9)
TDI_B: P107.26, U106.4 (Y1)
TDI_L: P101.27, P112.6, U107.4 (Y1)
TDI_R: P108.2, U105.4 (Y1)
TDI_T: P106.3, U104.4 (Y1)
TDO_B: P107.28, U106.6 (Y0)
TDO_L: P101.29, P112.2, U107.6 (Y0)
TDO_Q1: U104.3 (A)
TDO_Q2: U105.3 (A)
TDO_Q3: U106.3 (A)
TDO_Q4: U107.3 (A)
TDO_R: P108.4, U105.6 (Y0)
TDO_T: P106.5, U104.6 (Y0)
TL_X0_XLA_0i: P101.9, P103.21
TL_X0_XLA_0o: U122.5, U124.1
TL_X0_XLA_1i: P101.8, P103.20
TL_X0_XLA_1o: U122.6, U124.2
TL_X0_XLA_2i: P101.7, P103.19
TL_X0_XLA_2o: U122.7, U124.3
TL_X0_XLA_3i: P101.6, P103.18
TL_X0_XLA_3o: U122.8, U124.4
TL_X0_XLA_4i: P101.5, P103.17
TL_X0_XLA_4o: R117.1, R131.1
TMS: P112.5, U108.18 (B5), U116.13 (B10), U120.3 (A2), U128.3 (A2)
TMS_BUF_B: P105.29, U128.4 (Y2)
TMS_BUF_R: P108.12, U120.4 (Y2)
TMS_L: P101.19, U108.6 (A5)
TMS_T: P104.2, U116.11 (A10)
TRST_N_BUF_B: P105.24, U126.4 (Y2)
TRST_N_BUF_R: P108.7, U118.4 (Y2)
TRST_N_L: P101.24, U108.3 (A2)
TRST_N_T: P104.7, U116.8 (A7)
TR_X1_XLA_0i: P108.19, P110.7
TR_X1_XLA_0o: R171.2, R181.2
TR_X1_XLA_1i: P108.18, P110.6
TR_X1_XLA_1o: U132.1, U135.1
TR_X1_XLA_2i: P108.17, P110.5
TR_X1_XLA_2o: U132.2, U135.2
TR_X1_XLA_3i: P108.16, P110.4
TR_X1_XLA_3o: U132.3, U135.3
TR_X1_XLA_4i: P108.15, P110.3
TR_X1_XLA_4o: U132.4, U135.4
T_X1_XLA_0i: P104.21, P106.22
T_X1_XLA_0o: U102.5, U121.1
T_X1_XLA_1i: P104.20, P106.21
T_X1_XLA_1o: U102.6, U121.2
T_X1_XLA_2i: P104.19, P106.20
T_X1_XLA_2o: U102.7, U121.3
T_X1_XLA_3i: P104.18, P106.19
T_X1_XLA_3o: U102.8, U121.4
T_X1_XLA_4i: P104.17, P106.18
T_X1_XLA_4o: R151.2, R165.2

Notes on the sheet:
Power Connector
Nasty workaround for power supplies layout without power sensing
GLOBAL 20MHz CLK GENERATION
KiCad ERC FIX
JTAG SIGNAL BUFFERS
TL- POS = 1 ML- POS = 8 BL- POS = C MI- POS = 5 RI- POS = 7
JTAG SWITCH BOARD CONFIG
JTAG SIGNAL SWITCHES
L2 TDI/TDO SELECTORS
REFERENCE PAIR - Q4
REFERENCE PAIR - Q3
REFERENCE PAIR - Q2
REFERENCE PAIR - Q1
L2 MESH AND EDGE CONNECTORS
5V to 3V3 @ 1A
12V to 5V 2A Regulator
