jakelongo/l2_dev_board/l2_dev_alternative _nopwrsense/l2_pair.sch

## KiCad design l2_dev_alternative _nopwrsense/l2_pair.sch (2011-09-13)

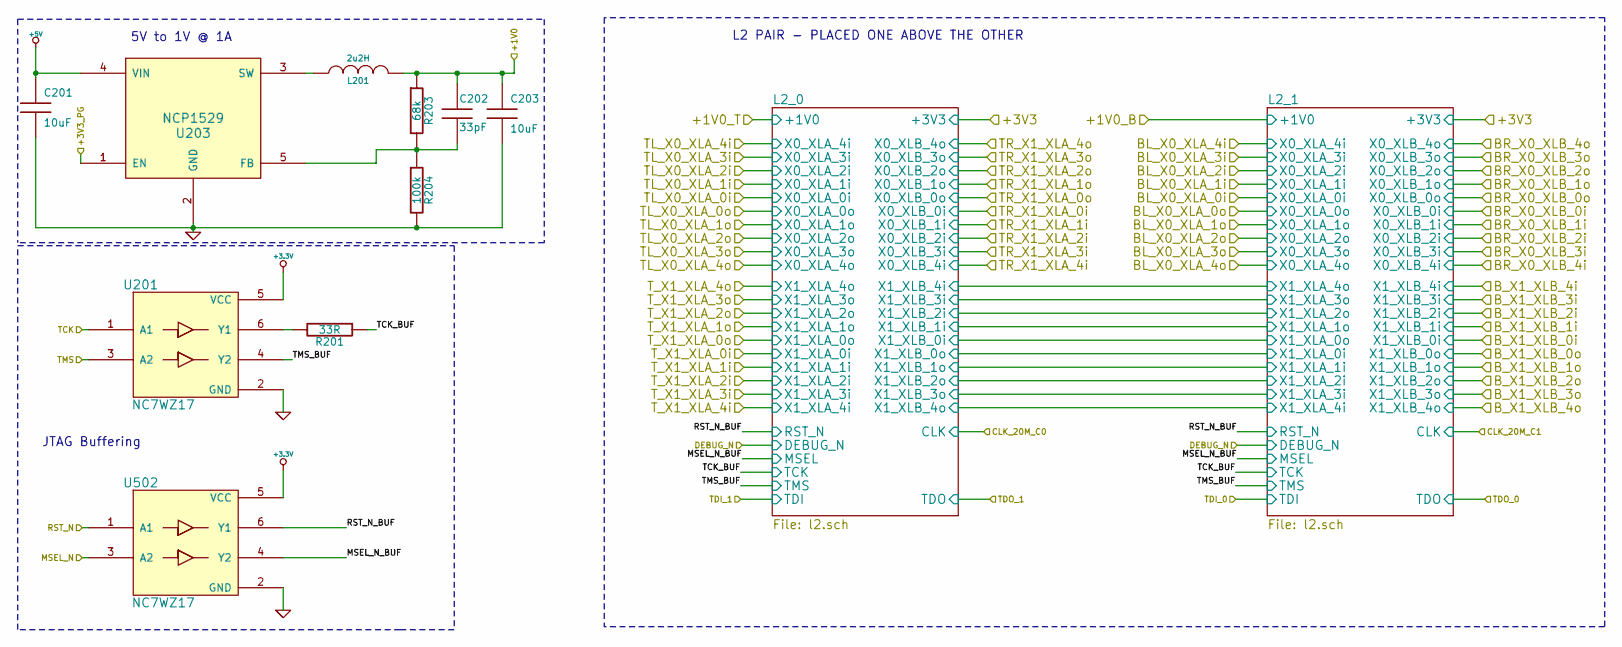
[picture p6: schematic l2_pair.sch]

Parts:
C201, C203: 10uF; 0603
C202: 33pF; 0603
L201: 2u2H; NCLV
R203: 68k; 0603
R204: 100k; 0603
R501: 33R; 0603
U201, U1102: NC7WZ17; SC70-6
U203: NCP1529; SOT23-5

Connections:
+1V0: C202.1, C203.1, L201.2, R203.1
+3.3V: U201.5 (VCC), U1102.5 (VCC)
+3V3_PG: U203.1 (EN)
+5V: C201.1, U203.4 (VIN)
GND: C201.2, C203.2, R204.2, U201.2 (GND), U203.2 (GND), U1102.2 (GND)
MSEL_N: U1102.3 (A2)
MSEL_N_BUF: U1102.4 (Y2)
unnamed: C202.2, R203.2, R204.1, U203.5 (FB)
unnamed: L201.1, U203.3 (SW)
unnamed: R501.2, U201.6 (Y1)
RST_N: U1102.1 (A1)
RST_N_BUF: U1102.6 (Y1)
TCK: U201.1 (A1)
TCK_BUF: R501.1
TMS: U201.3 (A2)
TMS_BUF: U201.4 (Y2)

Notes on the sheet:
L2 PAIR - PLACED ONE ABOVE THE OTHER
JTAG Buffering
5V to 1V @ 1A
