jakelongo/l2_dev_board/(commit log)

2011-07-24 add initial files
    [$savepcb.brd, 1st.brd, 1st.sch, 2nd.sch, L2.sch, L2DevBoard-init.brd, L2DevBoard.brd, L2DevBoard.dsn]
2011-07-24 gerber files
    [XPCB-018.xls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]
2011-07-24 speak to corin!
    [L2DevBoard-init.brd]
2011-07-25 cleaning up
    [$savepcb.brd, L2.sch, L2DevBoard-init.brd, L2DevBoard.brd, L2DevBoard.dsn, L2DevBoard.sch, power.sch]
2011-07-25 Started adding tracks
    [$savepcb.brd, L2.sch, L2DevBoard-init.brd, L2DevBoard.brd, L2DevBoard.sch, power.sch]
2011-07-25 layout which is deemed CRAP
    [$savepcb.brd, L2DevBoard.brd]
2011-07-25 brrrr!!!! trying to sort out vias!!
    [$savepcb.brd, L2DevBoard.brd]
2011-07-26 kicad vias not solved. Layout done. Check the clearance of the 12V zone
    [$savepcb.brd, L2DevBoard.brd]
2011-07-26 stamp of approval from Corin
    [$savepcb.brd, L2DevBoard.brd]
2011-07-26 ask Corin about inductor size for 1V0 NCP 1529 pin 3
    [$savepcb.brd, L2DevBoard.brd]
2011-07-26 looking good
    [$savepcb.brd, L2DevBoard.brd]
2011-07-27 Redesign for some of the schematics and for JTAG chain
    [$savepcb.brd, L2DevBoard.brd]
2011-07-27 Added appropriate sepearte power modules. Moved buffering to hiearchial sheet Buffering per 2 L2s due to harsh pull down on pads moved pins from global labels to heirachial
    [Buffering.sch, L1.sch, L1_Power.sch, L2.sch, L2DevBoard.sch, power.sch]
2011-07-27 squash and back to work!
    [$savepcb.brd, Buffering.sch, L1.sch, L1_Power.sch, L2.sch, L2DevBoard.sch, power.sch]
2011-07-28 more buffers and added connectors for end
    [L1.sch, L1_Power.sch, L2.sch, L2DevBoard.sch, power.sch]
2011-07-28 Isolated L1 stuff (inc. JTAG) in single sheet. Added buffered for the L2's JTAG control signals.
    [Buffering.sch, L1.sch, L1_Power.sch, L2.sch, L2DevBoard.sch, power.sch]
2011-07-28 removing old buffering and wanted to check point
    [Buffering.sch, L1.sch, L2.sch, L2DevBoard.sch, power.sch]
2011-07-28 missing header connector for 2 L2s. Find space!
    [Buffering.sch, L1.sch, L2.sch, L2DevBoard.sch, power.sch]
2011-07-29 workaround found for headers problem. Early start, good progess!
    [Buffering.sch, L1.sch, L2.sch, L2DevBoard.sch, power.sch]
2011-07-31 new design with heirachial and new libraries
    [$savepcb.brd, Buffering.sch, L1.sch, L2.sch, L2DevBoard.sch, l2.sch, l2_dev_board.sch, l2_pair.sch]
2011-08-01 Schematics back to previous progress but with better layout and heirarchial structure. Also created switch and rotary dip layout.
    [l1.sch, l2.sch, l2_dev_board.sch, l2_pair.sch]
2011-08-02 added switch and some logic to adjust JTAG. Need to confirm timing operations :s
    [l1.sch, l2.sch, l2_dev_board.sch, l2_pair.sch]
2011-08-02 generated ps and pdfs
    [l1.sch, l2.sch, l2_dev_board.sch, l2_pair.sch]
2011-08-02 added a buffer for reverse L1 but has an empty line, Might buffer in 2 directions!
    [l1.sch, l2.sch, l2_dev_board.sch, l2_pair.sch]
2011-08-03 JTAG signals buffered and connected
    [l1.sch, l2.sch, l2_dev_board.sch, l2_pair.sch]
2011-08-03 added L1 links and JTAG signals. I think a mux can buffer...
    [l1.sch, l2.sch, l2_dev_board.sch, l2_pair.sch]
2011-08-03 just need adc and done...hopefully
    [l1.sch, l2.sch, l2_dev_board.sch, l2_pair.sch]
2011-08-09 Laying out things. This is tedious work!
    [Power Measurments.xlsx, l1.sch, l2.sch, l2_dev_board.brd, l2_dev_board.sch, l2_pair.sch]
2011-08-09 removing extra footprints checkpoint!
    [$savepcb.brd, l1.sch, l2.sch, l2_dev_board.brd, l2_dev_board.sch, l2_pair.sch]
2011-08-09 xlinks wired. Need to create connector footprint
    [$savepcb.brd, l2_dev_board.brd]
2011-08-09 incorrect pin arrangement for top/bottom connectors fixed
    [$savepcb.brd, l1.sch, l2.sch, l2_dev_board.brd, l2_dev_board.sch, l2_pair.sch]
2011-08-09 power layout is a nightmare!
    [$savepcb.brd, l1.sch, l2.sch, l2_dev_board.brd, l2_dev_board.sch, l2_pair.sch]
2011-08-11 didn't push last night...lost 1 hours work! DAMN
    [$savepcb.brd, l2_dev_board.brd]
2011-08-11 added power islands for half the chips incl. L1
    [$savepcb.brd, l2_dev_board.brd]
2011-08-15 Yay its recovered!
    [$savepcb.brd, l2_dev_board.brd]
2011-08-16 some more power lines done
    [$savepcb.brd, l2_dev_board.brd]
2011-08-16 If you don't want power sensing you can make the board smaller! added the JTAG signals with buffers
    [$savepcb.brd, l1.sch, l2.sch, l2_dev_board.brd, l2_dev_board.sch, l2_pair.sch]
2011-08-16 started buffers for DEBUG signal
    [l1.sch, l2.sch, l2_dev_board.brd, l2_dev_board.sch, l2_pair.sch]
2011-08-17 add the datasheets for all the components and some example pcbs
2011-08-17 added extra buffers to remove lengthy lines. Also looking and audio board for L1 layout!
    [$savepcb.brd, l1.sch, l2.sch, l2_dev_board.brd, l2_dev_board.sch, l2_pair.sch]
2011-08-18 removing the L1 power island. Fork here if you want to keep it!
    [$savepcb.brd, l2_dev_board.brd]
2011-08-18 Routed L1 links and jtag. ~10 more components to go. Also just showed the PCB to Corin. He reckons the X-Links will work best on top and we risk reduced performance if they remain on the bottom
    [$savepcb.brd, l2_dev_board.brd]
2011-08-18 corin suggested a different layout, I'm giving it a shot
    [$savepcb.brd, XK-1A-RevA-BOM.xls, XK-1A-RevA-XY.xls, XPCB-010-BOM.xls, XPCB-010-XY.xls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]
2011-08-22 buffers are in and BOM started. Changed open drain buffers for normal buffers and added pull ups to the _N JTAG signals
    [$savepcb.brd, BOM.xlsx, l1.sch, l2.sch, l2_dev_board.brd, l2_dev_board.csv, l2_dev_board.sch, l2_dev_board2.csv]
2011-08-22 problems with the oscillator needed buffering!! argh!
    [$savepcb.brd, l1.sch, l2.sch, l2_dev_board.brd, l2_dev_board.sch, l2_pair.sch]
2011-08-22 added power island for 3v3 of l2s
    [$savepcb.brd, l2_dev_board.brd]
2011-08-23 Most of the components now in. About to try finalise the size!
    [$savepcb.brd, l1.sch, l2.sch, l2_dev_board.brd, l2_dev_board.sch, l2_pair.sch]
2011-08-23 adding links, looking full in the middle!
    [l1.sch, l2.sch, l2_dev_board.brd, l2_dev_board.sch, l2_pair.sch]
2011-08-24 about to try add in new power island zones
    [$savepcb.brd, l1.sch, l2.sch, l2_dev_board.brd, l2_dev_board.sch, l2_pair.sch]
2011-08-24 headache...must...get...pills! Reset supervisors up and L1 mostly done
    [$savepcb.brd, l1.sch, l2.sch, l2_dev_board.brd, l2_dev_board.sch, l2_pair.sch]
2011-08-24 TODO: I2C busses, LEDS and TDO/TDI for L1
    [$savepcb.brd, l2_dev_board.brd]
2011-08-25 need to check if L1 X-linkks need buffering
    [BOM.xlsx, l1.sch, l2.sch, l2_dev_board.brd, l2_dev_board.sch, l2_pair.sch]
2011-08-25 fixed buffer for DEBUG and TMS. Nets keep vanishing...KICAD!!!!
    [$savepcb.brd, l1.sch, l2.sch, l2_dev_board.brd, l2_dev_board.sch, l2_pair.sch]
2011-08-30 added pull ups for I2C bus, checking design over
    [$savepcb.brd, l1.sch, l2.sch, l2_dev_board.brd, l2_dev_board.sch, l2_pair.sch]
2011-08-30 save before adding in LEDs in Layout
    [$savepcb.brd, l1.sch, l2.sch, l2_dev_board.brd, l2_dev_board.sch, l2_pair.sch]
2011-08-31 replaced single I2C bus with individual busses for high speed conversions
    [$savepcb.brd, l1.sch, l2.sch, l2_dev_board.brd, l2_dev_board.sch, l2_pair.sch]
2011-08-31 some cleanup. Also the LEDs were added in the last commit
    [Power Measurments.xlsx, l2_dev_board.csv, l2_dev_board2.csv]
2011-08-31 removed old files and renamed old layout
    [$savepcb.brd, 1st.brd, 1st.sch, 2nd.sch, Buffering.sch, L1.sch, L1_Power.sch, L2.sch]
2011-08-31 copy files for removing power sense on nopwrsense board
    [$savepcb.brd, BOM.xlsx, XK-1A-RevA-BOM.xls, XK-1A-RevA-XY.xls, XPCB-010-BOM.xls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]
2011-08-31 doing the l2s alone
    [$savepcb.brd, l1.sch, l2.sch, l2_dev_board.brd, l2_dev_board.sch, l2_pair.sch]
2011-08-31 half the L2s Done. Need to finalise on power supply
    [l2_dev_board.brd]
2011-08-31 added JTAG out on the right
    [l2_dev_board.brd]
2011-09-01 +1V0 power islands ready
    [$savepcb.brd, l2.sch, l2_dev_board.brd, l2_dev_board.sch, l2_pair.sch]
2011-09-01 logic error! remove the mux and put SW_4 instead
    [l2.sch, l2_dev_board.brd, l2_dev_board.sch, l2_pair.sch]
2011-09-01 added buffers for most of the signals now. almost done
    [l2.sch, l2_dev_board.brd, l2_dev_board.sch, l2_pair.sch]
2011-09-02 added term resistors for xlinks and changed RST buffers to open drain
    [l2.sch, l2_dev_board.sch, l2_pair.sch]
2011-09-05 monumental cockup- re-design point here!
    [l2.sch, l2_dev_board.sch, l2_pair.sch]
2011-09-05 ugh, this is painful!
    [$savepcb.brd, l2.sch, l2_dev_board.brd, l2_dev_board.sch, l2_pair.sch]
2011-09-06 almost all the links in, some of the JTAG in. Surprisingly nice :)
    [$savepcb.brd, l2.sch, l2_dev_board.brd, l2_dev_board.sch, l2_pair.sch]
2011-09-06 done for the day, couple more links from last commit
    [$savepcb.brd, l2.sch, l2_dev_board.brd, l2_dev_board.sch, l2_pair.sch]
2011-09-07 almost done. adding cutouts for power islands
    [$savepcb.brd, l2.sch, l2_dev_board.brd, l2_dev_board.sch, l2_pair.sch]
2011-09-08 need to check design
    [$savepcb.brd, l2_dev_board.brd]
2011-09-08 going to flood the top!
    [$savepcb.brd, BOM.xlsx, l2.sch, l2_dev_board.brd, l2_dev_board.sch, l2_pair.sch]
2011-09-08 kicad crashed! time to go home!
    [$savepcb.brd, l2_dev_board.brd]
2011-09-09 power sensless done, about to perform clean operation
    [$savepcb.brd, BOM_fin.xlsx, l2.sch, l2_dev_board.brd, l2_dev_board.sch, l2_dev_board_backup.brd, l2_pair.sch]
2011-09-13 working on power sense again now. The normal board should be more or less done!
    [$savepcb.brd, BOM.xls, BOM.xlsx, BOM_fin.xlsx, l1.sch, l2.sch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]
2011-09-13 copied over new files from basic board
    [$savepcb.brd, BOM.xlsx, XK-1A-RevA-BOM.xls, XK-1A-RevA-XY.xls, XPCB-010-BOM.xls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]
2011-09-13 cleaning up a bit:
    [$savepcb.brd, XK-1A-RevA-BOM.xls, XK-1A-RevA-XY.xls, XPCB-010-BOM.xls, XPCB-010-XY.xls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]
2011-09-15 almost done!
    [l2.sch, l2_dev_board.brd, l2_dev_board.sch, l2_pair.sch]
2011-09-15 done :)
    [l2.sch, l2_dev_board.brd, l2_dev_board.sch, l2_pair.sch]
